ExploreEmbedded/Hornbill-ESP32-Minima/Design Files/CAD images/Angled image.jpg

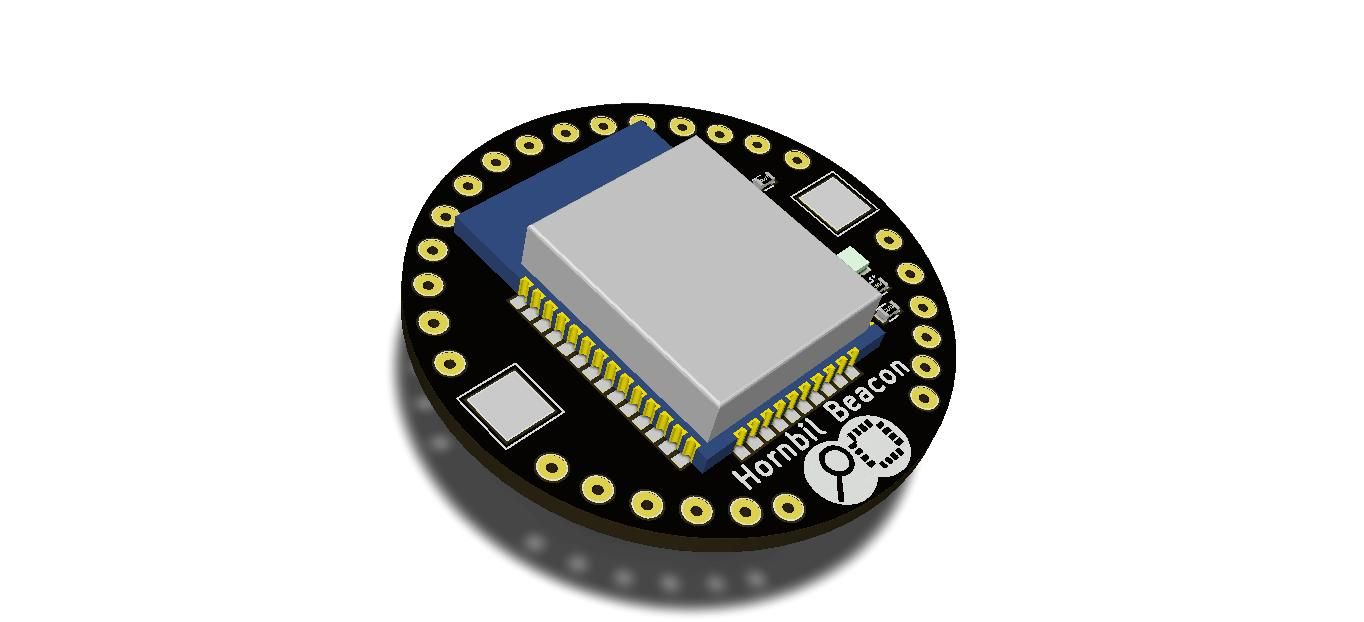
Design Files/CAD images/Angled image.jpg
