ExploreEmbedded/Hornbill-ESP32-Minima/Design Files/CAD images/Front image image.jpg

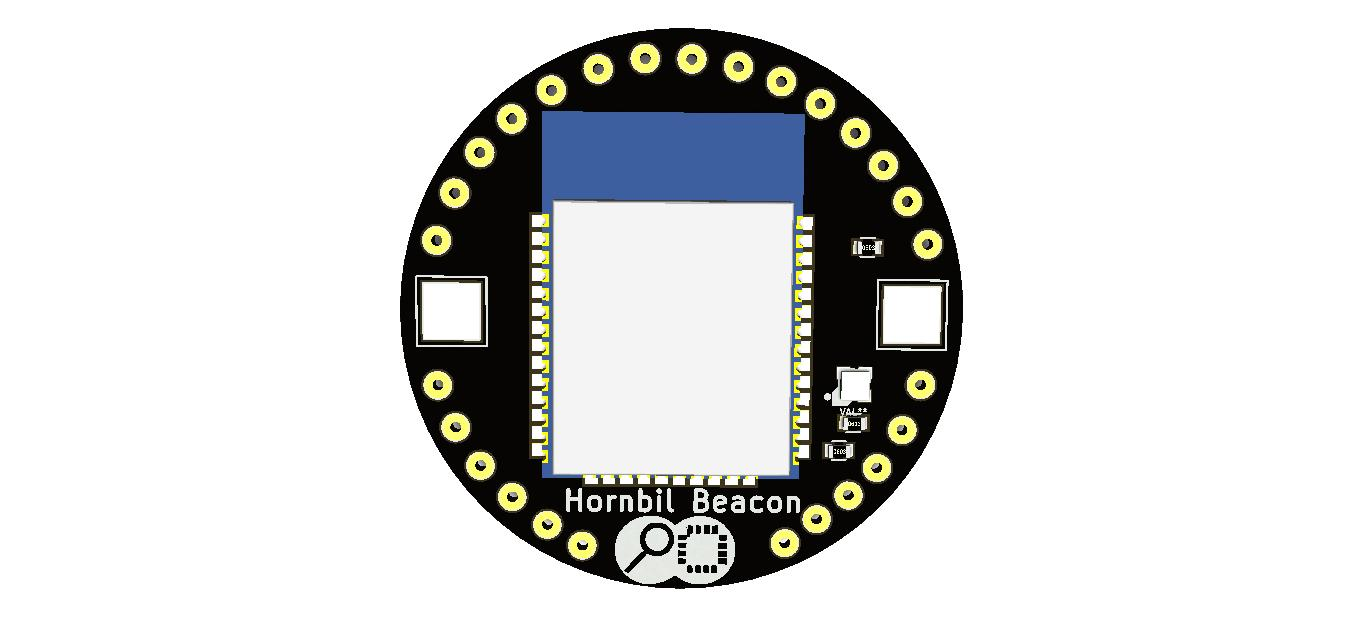
Design Files/CAD images/Front image image.jpg
