ExploreEmbedded/Hornbill-ESP32-Minima/Design Files/CAD images/Hornbill ESP32 Minima.png

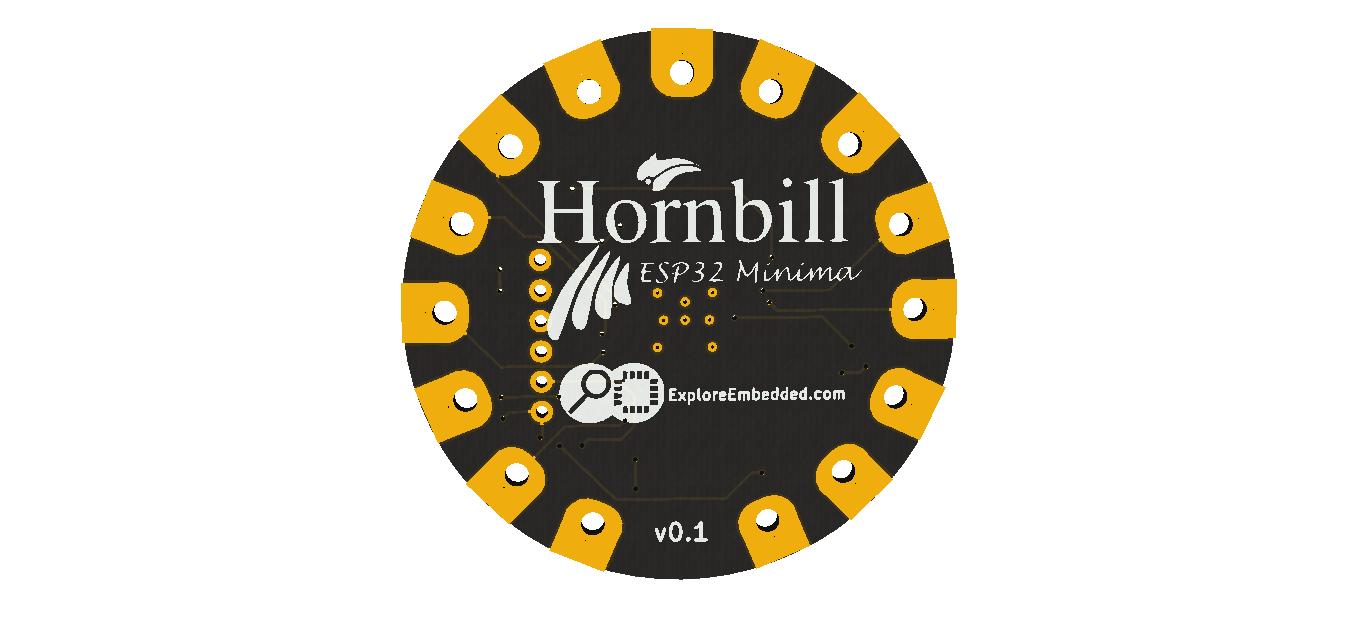
Design Files/CAD images/Hornbill ESP32 Minima.png
