ExploreEmbedded/Hornbill-ESP32-Minima/Design Files/CAD images/Rear image image.jpg

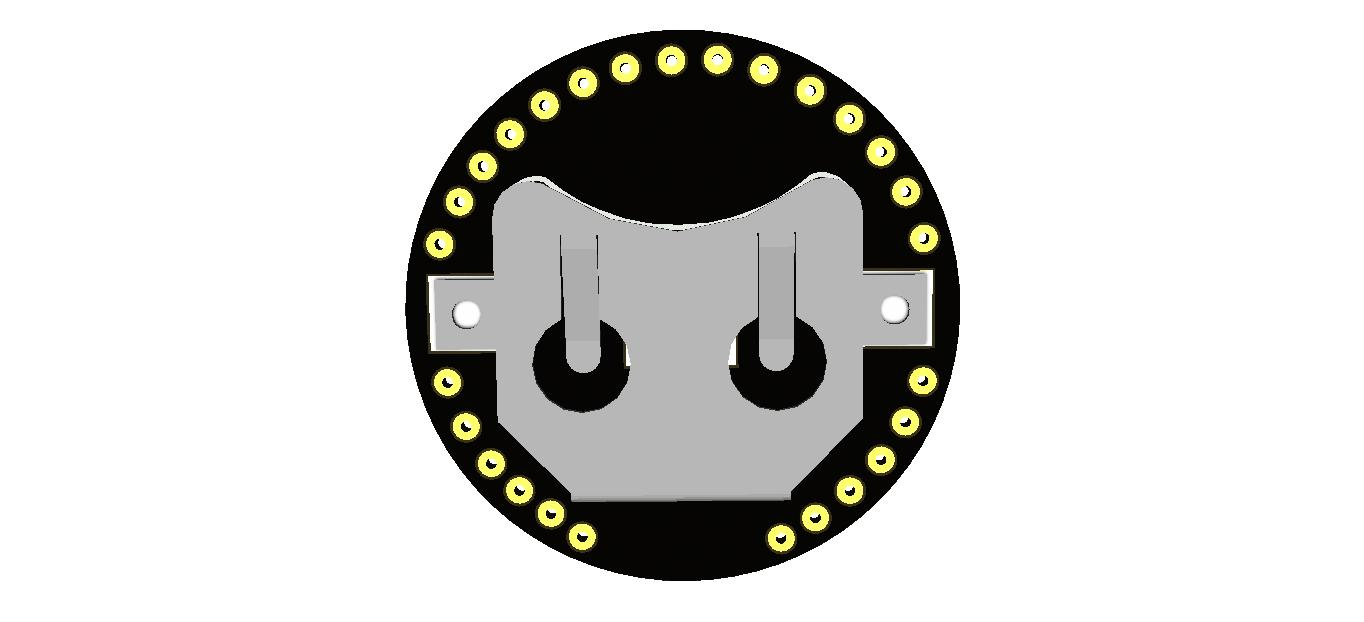
Design Files/CAD images/Rear image image.jpg
