ExploreEmbedded/Hornbill-ESP32-Minima/Others/BOM/Hornbill_minima_BOMv0.1.xls

BOM
Product Name: Hornbill ESP32 minima
Version:V0.1
Issue Date:17/03/2017
Quantity | 100
Item No. (??) | Reference Des (????) | Qty (??) | Catalog (??) | Part_Description (????) | Part_Value (???) | Part_Package (????) | Manufacturers Name (??????) | Manufacturers Part No. (??????) | Distributors Name (?????) | Distributors Part No. (?????) | Unit Price (??) | Price Break To Use (????????) | Notes/Remark (??)
1 | C5 | 1 | Capacitor | CAP CER 1UF 6V 10% X7R 0603 | 1uF | 603
2 | C6 | 1 | Capacitor | CAP CER 2.2UF 6V 10% X7R 0603 | 2.2uF | 603
3 | C1 | 1 | Capacitor | CAP Tantalum 100UF 6V 10% X7R 1206 | 100uF | 1206/Case 'A'
4 | C3,C4 | 2 | Capacitor | CAP CER 15pF 25V 10% X7R 0603 | 15pF | 603
5 | C2 | 1 | Capacitor | CAP CER 0.1uF 25V 10% X7R 0603 | 0.1uF | 603
7 | D3 | 1 | LED | LED, SMD, Red , 0603 | SMD LED | 603
9 | U1 | 1 | Regulator | 3.3V Regulator, 0.6A, LDO | AP2112K-3.3V | SOT-23-5
10 | Q3,Q4 | 2 | Transistor | SMD Transistor, S8050 | S8050 | SOT-23
11 | Y1 | 1 | Crystal | 32.768kHz ±20ppm Crystal 12.5pF 70 kOhm -40°C ~ 85°C Surface Mount 2-SMD, No Lead | 32.768KHZ | SMD | Abrocn LLC | ABS07-32.768KHZ-T | DigiKey | 535-9542-2-ND
12 | P2 | 1 | Pin header | Male straight 2.54mm pitch Pin header | 6 Pin | -
1. Recommended Distributor: Digi-Key, Mouser, Avnet Express, Farnell.
2. Catalog: Capacitor,Resister,Diode,Connector,Transistor,IC,PROTECTOR CATEGORY,OTHER
3. Required Fields: Item No, Reference Des, Qty, Catalog, Part_Value, Part Package
Optional Fields: Part_Description, Manufacturers Name, Manufacturers Part No, Distributors Name, Distributors Part No, Unit Cost, Price break to use, Notes/Remark
