ExploreEmbedded/Hornbill-ESP32-Minima/Design Files/Beacon32.pdf

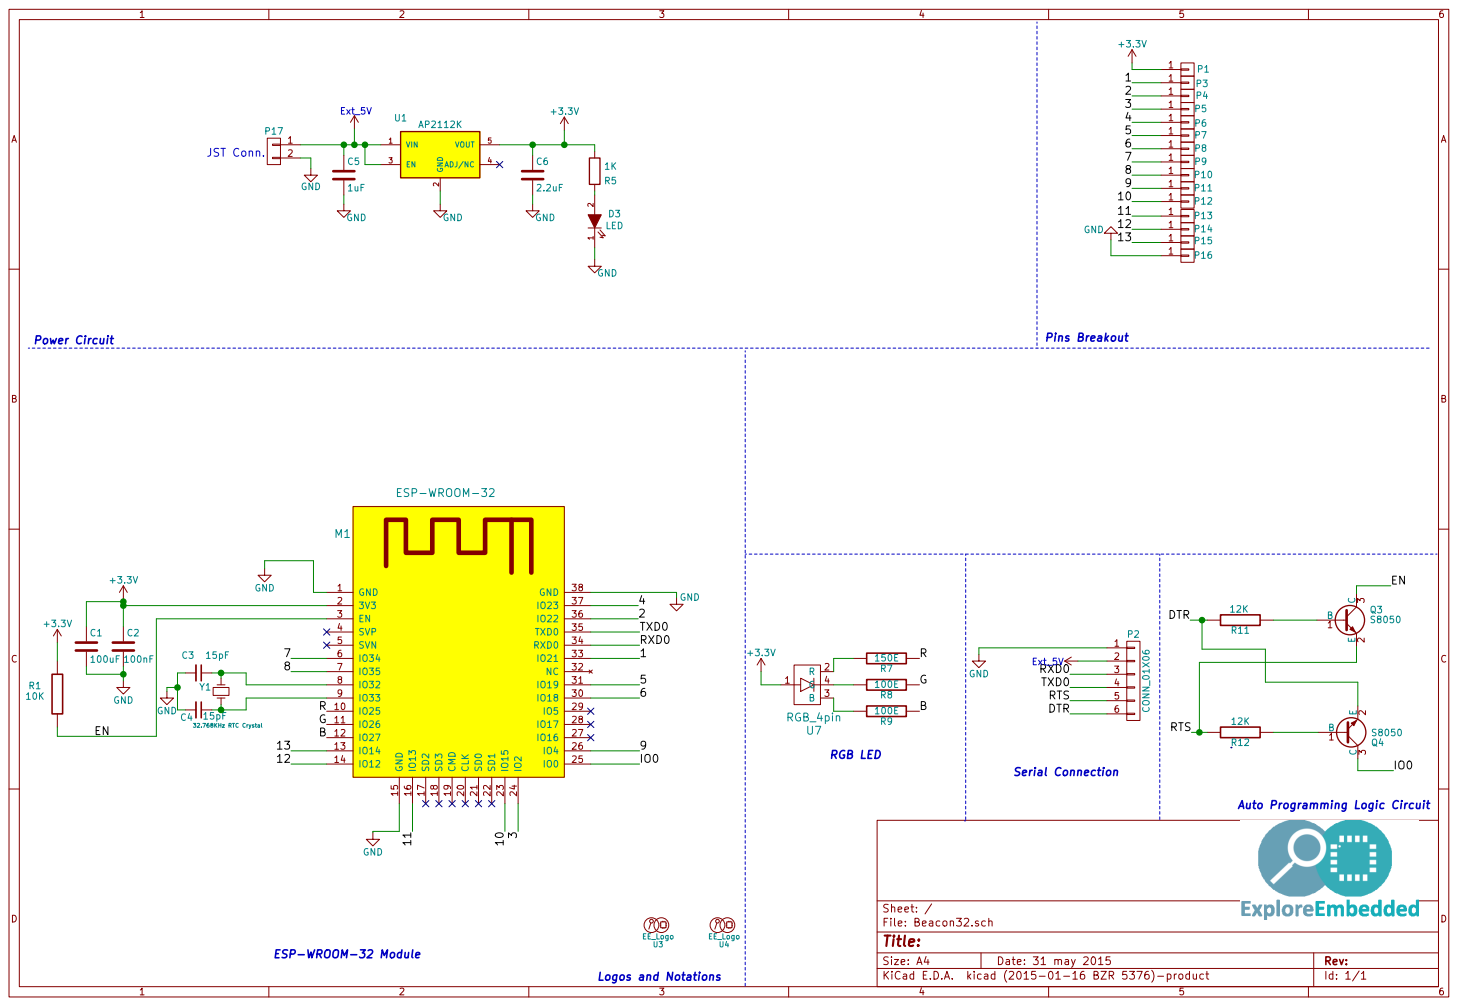
[picture p5: page 1]

2 EN 3 ADJ/NC 4 VOUT 5 U1 AP2112K GND

Auto Programming Logic Circuit
