ExploreEmbedded/Hornbill-ESP32-Minima/Others/Process Sheet ESP32 minima.pdf

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

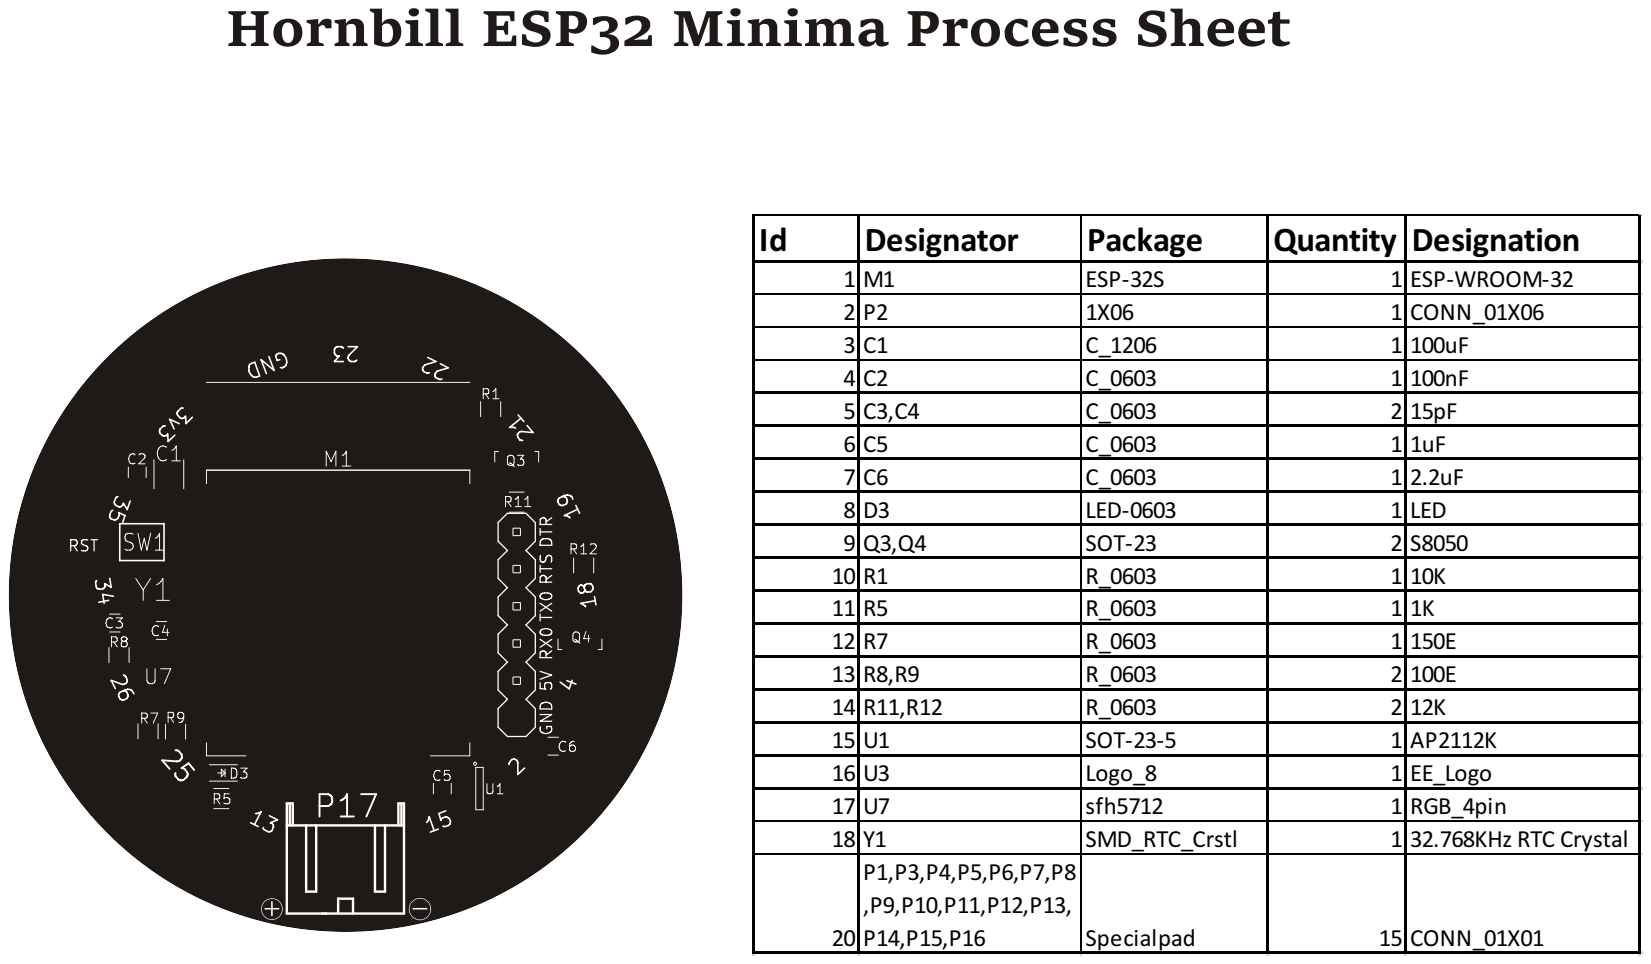
[picture p6: page 1]
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
