ExploreEmbedded/Hornbill-ESP32-Minima/Design Files/Beacon32.kicad_pcb

## KiCad design Design Files/Beacon32.kicad_pcb (2017-06-08)

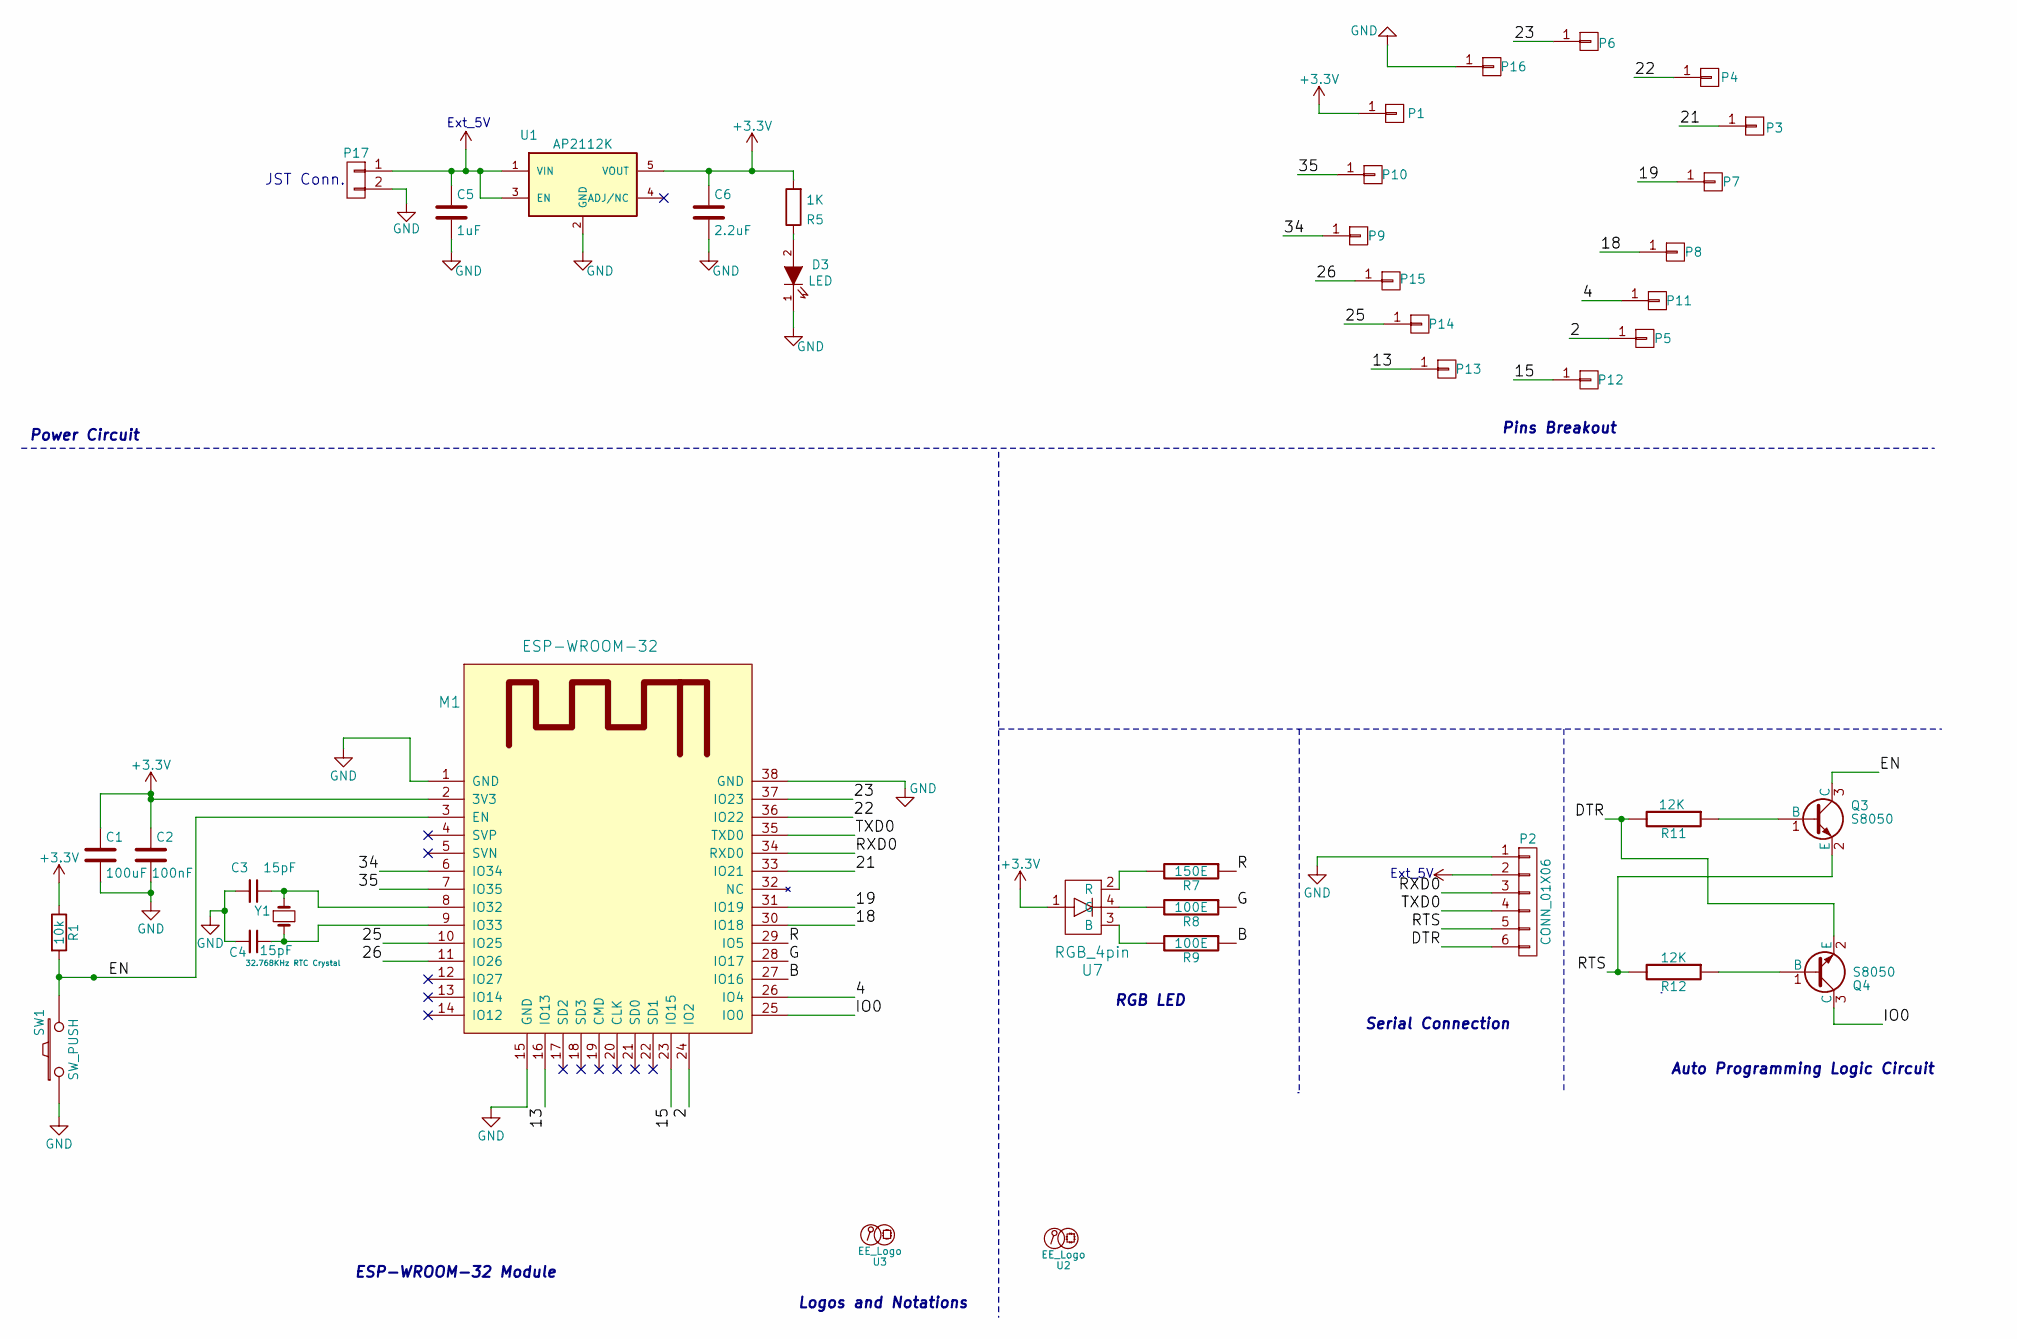
[picture p7: schematic Beacon32.sch]

Parts:
C1: 100uF; C_1206
C2: 100nF; C_0603
C3, C4: 15pF; C_0603
C5: 1uF; C_0603
C6: 2.2uF; C_0603
D3: LED; LED-0603
M1: ESP-WROOM-32; ESP-32S
P1, P3, P4, P5, P6, P7, P8, P9, P10, P11, P12, P13, P14, P15, P16: CONN_01X01; MinimaPad_3.5mm
P2: CONN_01X06; 1X06
P17: CONN_01X02; s2b-ph-sm4-tb
Q3, Q4: S8050; SOT-23
R1: 10k; R_0603
R5: 1K; R_0603
R7: 150E; R_0603
R8, R9: 100E; R_0603
R11, R12: 12K; R_0603
SW1: SW_PUSH; smd_push2_New
U1: AP2112K; SOT-23-5
U2: EE_Logo; Hornbill_ESP32_minima
U3: EE_Logo; Logo_8
U7: RGB_4pin; RGB_SMD_4pin_New
Y1: 32.768KHz RTC Crystal; SMD_RTC_Crstl

Connections:
+3V3: C1.1, C2.1, C6.1, M1.2 (3V3), P1.1, R1.1, R5.2, U1.5 (VOUT), U7.1
+5V: C5.1, P2.2, P17.1, U1.1 (VIN), U1.3 (EN)
/2: M1.24 (IO2), P5.1
/4: M1.26 (IO4), P11.1
/13: M1.16 (IO13), P13.1
/15: M1.23 (IO15), P12.1
/18: M1.30 (IO18), P8.1
/19: M1.31 (IO19), P7.1
/21: M1.33 (IO21), P3.1
/22: M1.36 (IO22), P4.1
/23: M1.37 (IO23), P6.1
/25: M1.10 (IO25), P14.1
/26: M1.11 (IO26), P15.1
/34: M1.6 (IO34), P9.1
/35: M1.7 (IO35), P10.1
/B: M1.27 (IO16), R9.1
/DTR: P2.6, Q4.2 (E), R11.2
/EN: M1.3 (EN), Q3.3 (C), R1.2, SW1.2
/G: M1.28 (IO17), R8.1
/IO0: M1.25 (IO0), Q4.3 (C)
/R: M1.29 (IO5), R7.1
/RTS: P2.5, Q3.2 (E), R12.2
/RXD0: M1.34 (RXD0), P2.3
/TXD0: M1.35 (TXD0), P2.4
GND: C1.2, C2.2, C3.2, C4.2, C5.2, C6.2, D3.1 (K), M1.1 (GND), M1.15 (GND), M1.38 (GND), P2.1, P16.1, P17.2, SW1.1, U1.2 (GND)
unnamed: C3.1, M1.8 (IO32), Y1.1
unnamed: C4.1, M1.9 (IO33), Y1.2
unnamed: D3.2 (A), R5.1
unnamed: Q3.1 (B), R11.1
unnamed: Q4.1 (B), R12.1
unnamed: R7.2, U7.2 (R)
unnamed: R8.2, U7.4 (G)
unnamed: R9.2, U7.3 (B)

Notes on the sheet:
RGB LED
Logos and Notations
Pins Breakout
Power Circuit
Auto Programming Logic Circuit
ESP-WROOM-32 Module
Ext_5V
Serial Connection
JST Conn.

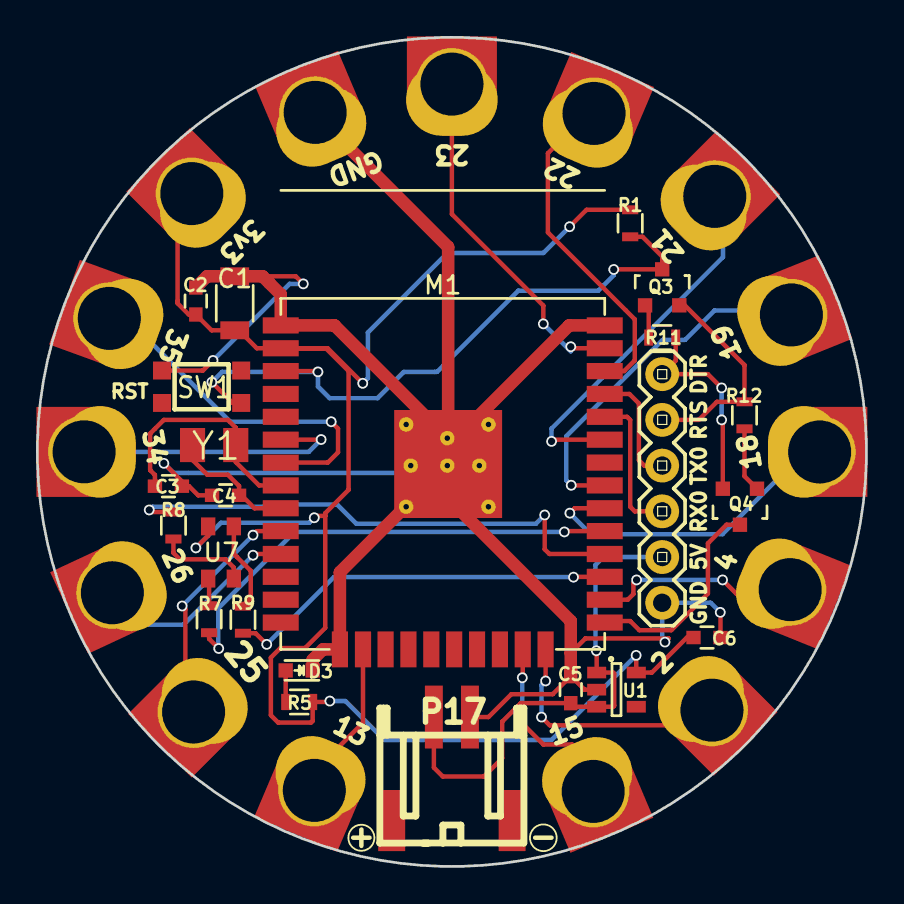
[picture p8: board Beacon32.kicad_pcb from above]

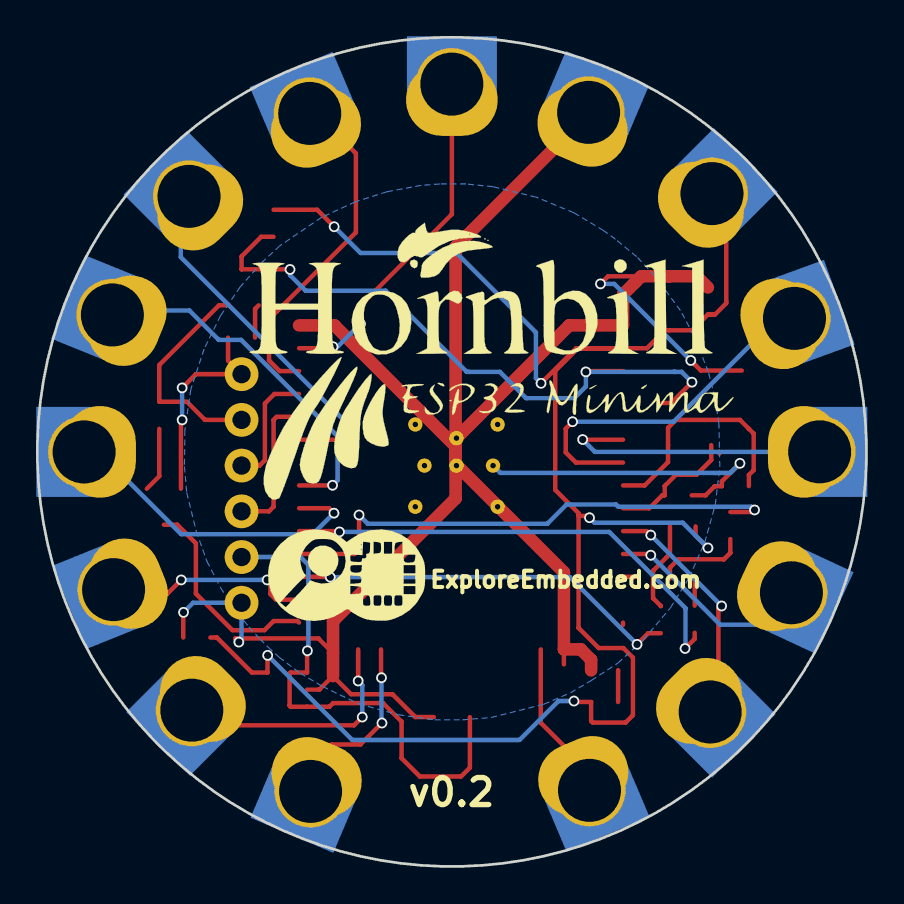
[picture p9: board Beacon32.kicad_pcb from below]

Board: 2 copper layers, 46.1 x 46.1 mm, 40 parts (2 on the bottom side), 33 nets.
