ExploreEmbedded/Hornbill-ESP32-Minima/(threads)

Thread 1 (2017-04-26):

Add micro switch for reset

raghavendrahassy, 2017-04-26:
Add micro switch for reset

sharanago, 2017-04-27:
Added Switch for reset as in the dev board
Changed RGB led Footprint

Closed 2017-04-27.
