ExploreEmbedded/Hornbill-ESP32-Minima/(commit log)

2017-04-22 Added Design Files
    [Beacon32.kicad_pcb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]
2017-04-22 BOM generated
    [Beacon32.sch, Hornbill ESP32 minima BOM v0.1.csv, Hornbill_minima_BOMv0.1.xls]
2017-04-27 Issue closed
    Added Reset switch and RGB footprint changed
    [Beacon32.kicad_pcb, Beacon32.sch]
2017-04-27 Gerber file genereted
    [Beacon32-B_Cu.gbr, Beacon32-B_Mask.gbr, Beacon32-B_SilkS.gbr, Beacon32-F_Cu.gbr, Beacon32-F_Mask.gbr, Beacon32-F_SilkS.gbr, Beacon32.drl]
2017-05-01 Drill Size Increased
    [Beacon32.kicad_pcb, Beacon32.sch]
2017-05-02 Resized pads to 3.5mm
    [Beacon32.kicad_pcb, Beacon32.sch]
2017-05-02 Gerber file generated for v0.2
    [Beacon32-B.Cu.gbr, Beacon32-B.Mask.gbr, Beacon32-B.SilkS.gbr, Beacon32-F.Cu.gbr, Beacon32-F.Mask.gbr, Beacon32-F.SilkS.gbr, Beacon32.drl]
2017-06-07 Process sheet added
    [Hornbill ESP32 minima BOM v0.1.csv, Hornbill ESP32 minima BOM v0.1.xls]
2017-06-08 Process sheet modified
    [Beacon32.kicad_pcb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]
